mlarroque/electro2-TP1/cover.tex

%%%%%%%%%%%%%%%%%%%%%%%%%%%%%%%%%%%%%%%%% 
% University Assignment Title Page  
% LaTeX Template % Version 1.0 (27/12/12) 
% % This template has been downloaded from: 
% http://www.LaTeXTemplates.com % % Original author: 
% WikiBooks (http://en.wikibooks.org/wiki/LaTeX/Title_Creation) % % License: 
% CC BY-NC-SA 3.0 (http://creativecommons.org/licenses/by-nc-sa/3.0/) 
%  % Instructions for using this template: 
% This title page is capable of being compiled as is. This is not useful for  
% including it in another document. To do this, you have two options:  
% % 1) Copy/paste everything between \begin{document} and \end{document}  
% starting at \begin{titlepage} and paste this into another LaTeX file where you  
% want your title page. 
% OR % 2) Remove everything outside the \begin{titlepage} and \end{titlepage} and  
% move this file to the same directory as the LaTeX file you wish to add it to.  
% Then add \input{./title_page_1.tex} to your LaTeX file where you want your 
% title page. % %%%%%%%%%%%%%%%%%%%%%%%%%%%%%%%%%%%%%%%%% %\title{Title page with logo} 
%---------------------------------------------------------------------------------------- 
%	PACKAGES AND OTHER DOCUMENT CONFIGURATIONS 
%----------------------------------------------------------------------------------------      
\begin{titlepage}          
\newcommand{\HRule}
{\rule{\linewidth}{0.5mm}} 
% Defines a new command for the horizontal lines, change thickness here              
\center 
% Center everything on the page               
%----------------------------------------------------------------------------------------    
%	HEADING SECTIONS     
%----------------------------------------------------------------------------------------              
\textsc{\LARGE Instituto Tecnológico de Buenos Aires}\\[2cm] 
% Name of your university/college     
\textsc{\Large 22.12 - Electronica II}\\[1.5cm] 
% Major heading such as course name     
%
\textsc{\large Trabajo Práctico de Laboratorio N°1}\\[0.5cm] 
% Minor heading such as course title              
%----------------------------------------------------------------------------------------    
%	TITLE SECTION    
%----------------------------------------------------------------------------------------          
\HRule \\[0.5cm]     
{ \huge \bfseries Fuente Regulada de Tensión}\\[0.4cm] % Title of your document     
\HRule \\[2cm]               
%----------------------------------------------------------------------------------------     
%	AUTHOR SECTION     
%----------------------------------------------------------------------------------------             
\begin{minipage}{0.4\textwidth}     
\begin{flushleft} \large     
\emph{Grupo 2:}\\		
%names     
[.3cm]     Matías \textsc{Larroque}\\     Leg. 56597\\      [.3cm]         
Tomás Agustín \textsc{González Orlando}\\     Leg. 57090\\      [.3cm]        
Manuel \textsc{Mollón}\\     Leg. 58023\\      [.3cm]     
Ezequiel \textsc{Vijande}\\     Leg. 58057\\      [.3cm]     
\end{flushleft}     
\end{minipage}     ~     
\begin{minipage}{0.4\textwidth}     
\begin{flushright} \large     \emph{Profesor:} \\     [.3cm]     
Gustavo Abraham \textsc{Hirchoren}\\ % Supervisor's Name 
Javier David \textsc{Petrucci}\\     \end{flushright}     \end{minipage}\\[2cm]              
% If you don't want a supervisor, uncomment the two lines below and remove the section above     
%\Large \emph{Author:}\\     
%John \textsc{Smith}\\[3cm] 
% Your name             
%----------------------------------------------------------------------------------------     
%	DATE SECTION     
%----------------------------------------------------------------------------------------              
\vfill     
{\large Entregado: 25 de Abril de 2019}\\[2cm] 
% Date, change the \today to a set date if you want to be precise              %----------------------------------------------------------------------------------------     
%	LOGO SECTION    
%----------------------------------------------------------------------------------------             
%\includegraphics{logo.png}\\[1cm] 
% %Include a department/university logo - this will require the graphicx %package               %----------------------------------------------------------------------------------------              
%\vfill % Fill the rest of the page with whitespace              
\end{titlepage}
