mlarroque/electro2-TP1/Altium/Project Outputs for fuenteRegulada/Board Information - fuenteRegulada.txt

Board Information Report
Filename     : C:\Users\malen\Desktop\ELECTRONICA II\electro2-TP1\Altium\fuenteRegulada.PcbDoc
Date         : 15/4/2019
Time         : 10:05:56
Time Elapsed : 00:00:00

General
    Board Size, 50mmx50mm
    Components on board, 19
count : 2

Routing Information
    Routing completion, 100,00%
    Connections, 37
    Connections routed, 37
    Connections remaining, 0
count : 4
