mlarroque/electro2-TP1/imagenes/medRend6con5ohms.PNG

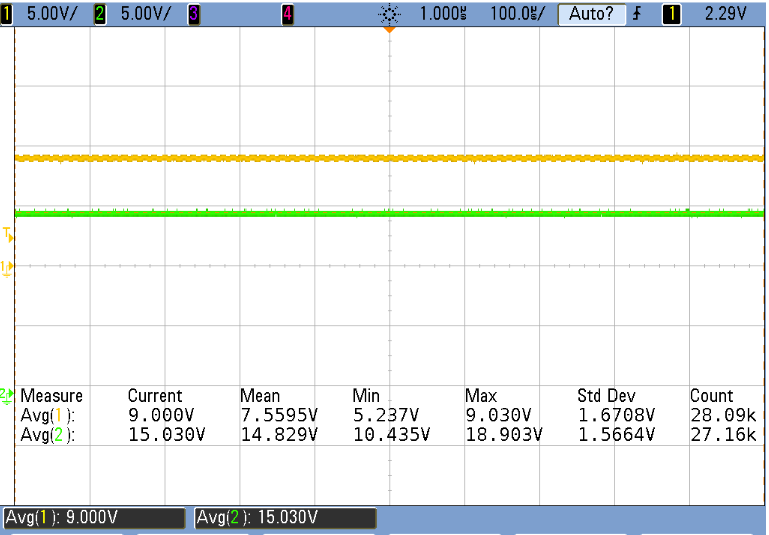
imagenes/medRend6con5ohms.PNG
