mlarroque/electro2-TP1/imagenes/medRend180ohms.PNG

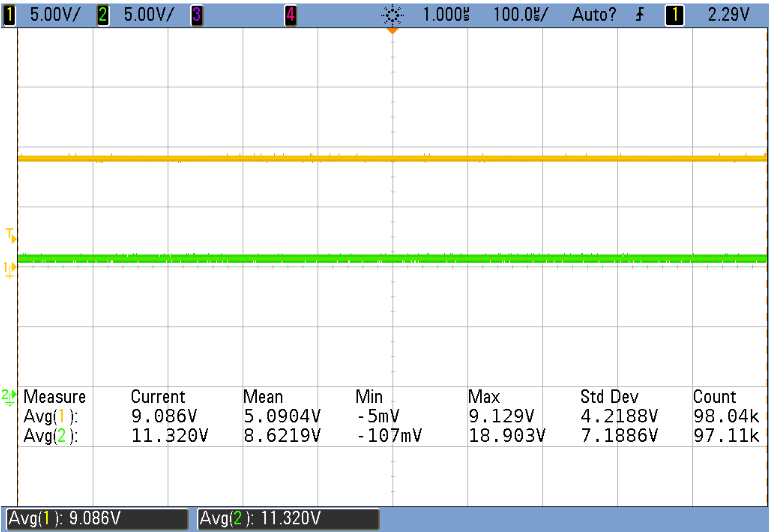
imagenes/medRend180ohms.PNG
