mlarroque/electro2-TP1/imagenes/medRend190ohms.PNG

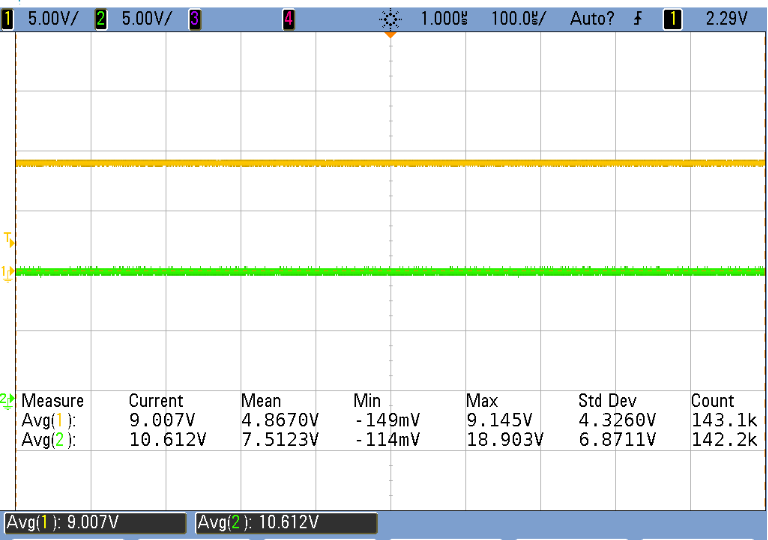
imagenes/medRend190ohms.PNG
