mlarroque/electro2-TP1/imagenes/medRendVacio.PNG

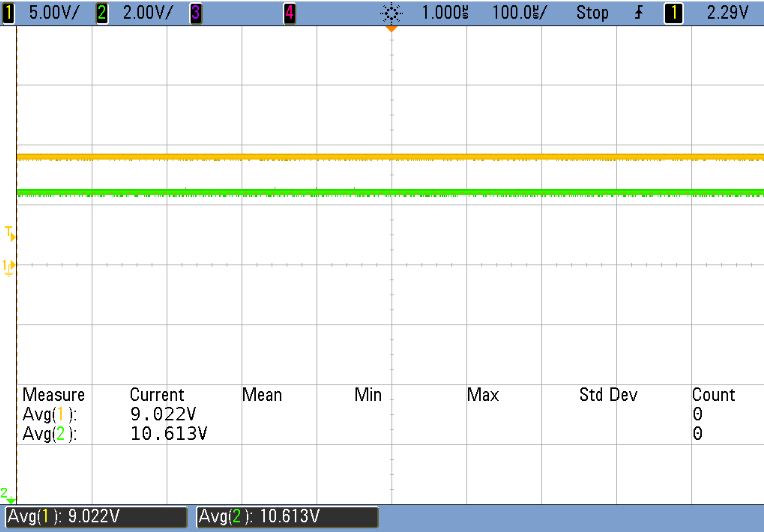
imagenes/medRendVacio.PNG
