mlarroque/electro2-TP1/mediciones/rend190ohms.png

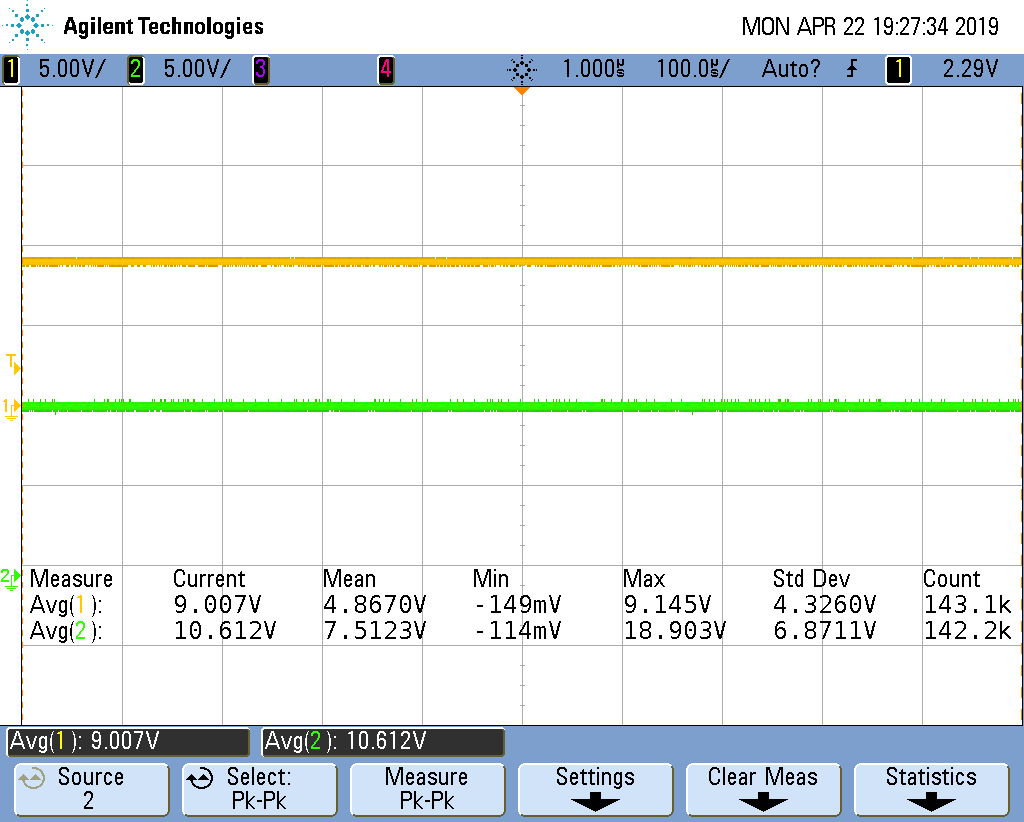
mediciones/rend190ohms.png
