mlarroque/electro2-TP1/mediciones/scope_21.png

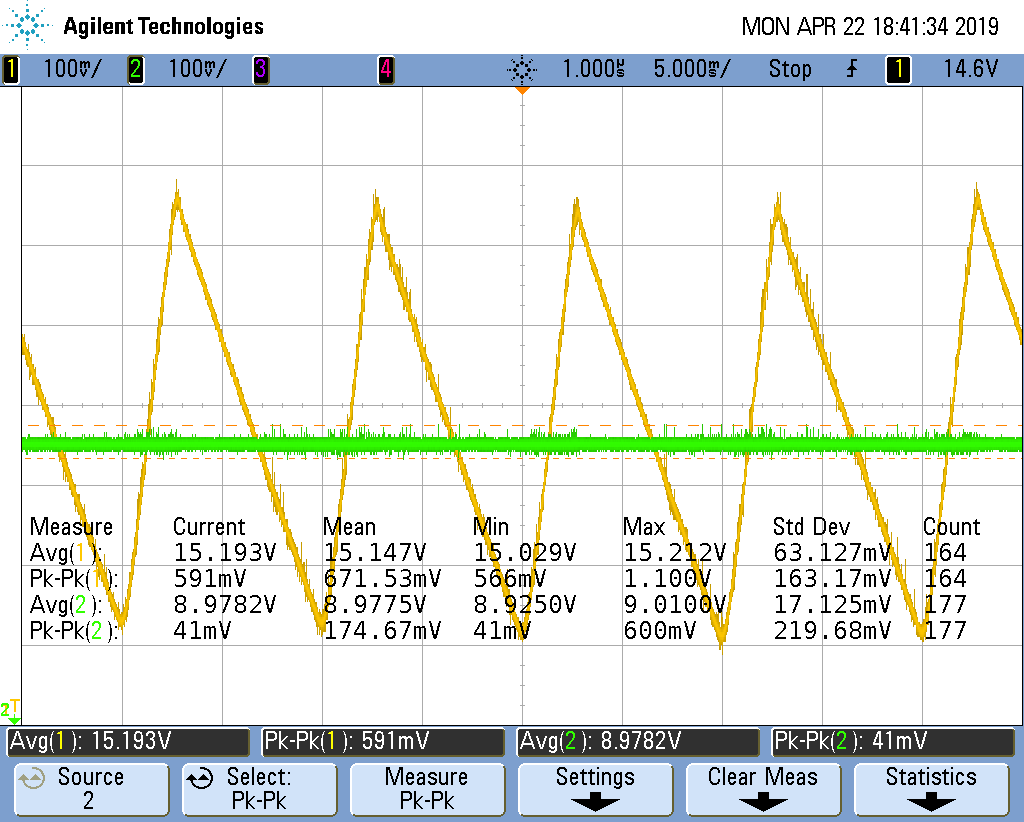
mediciones/scope_21.png
