mlarroque/electro2-TP1/mediciones/scope_22.png

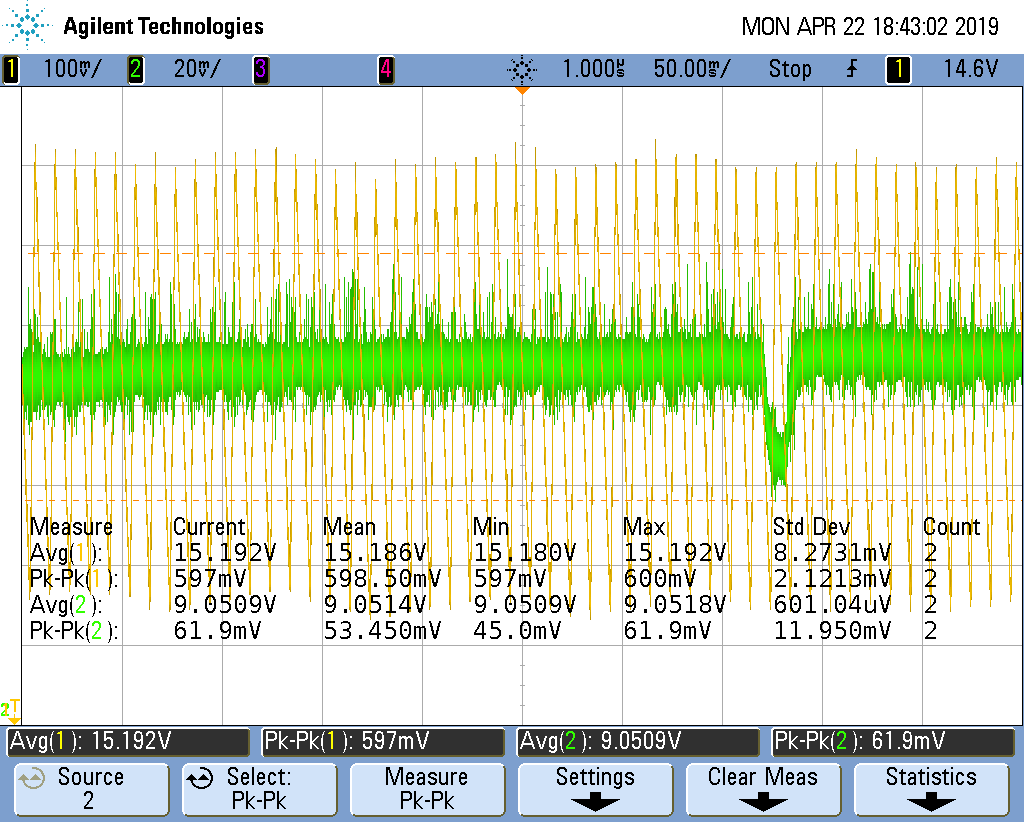
mediciones/scope_22.png
