mlarroque/electro2-TP1/mediciones/scope_23.png

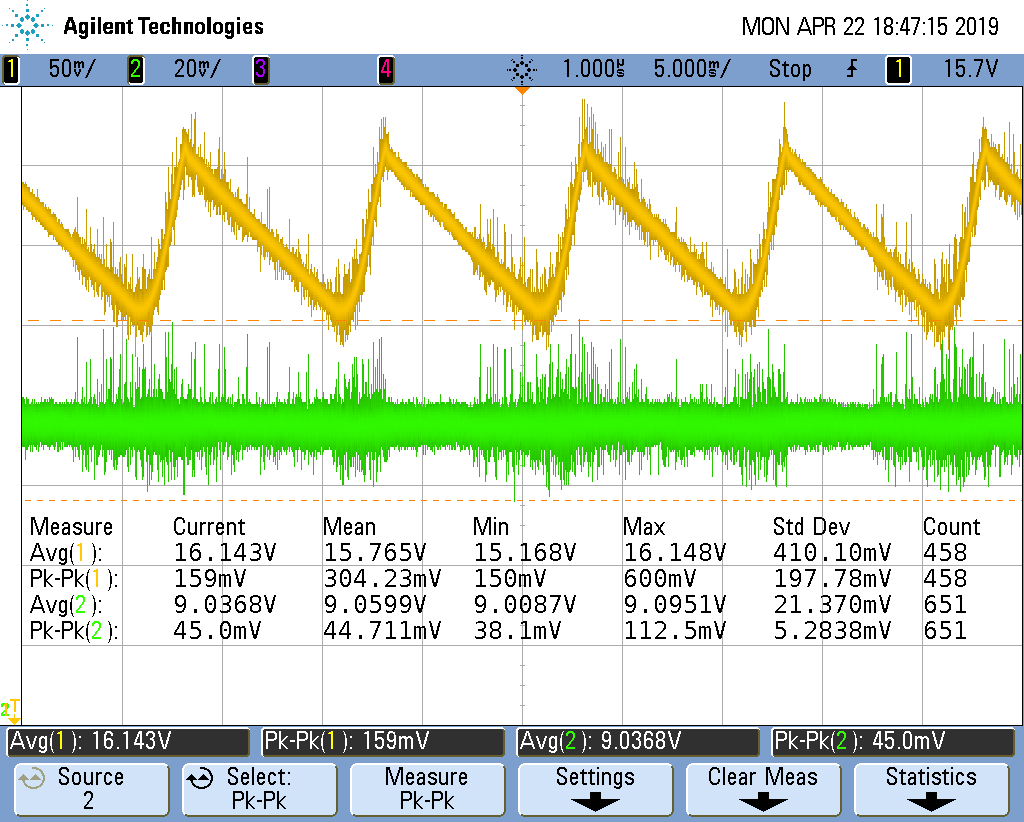
mediciones/scope_23.png
