mlarroque/electro2-TP1/mediciones/scope_24.png

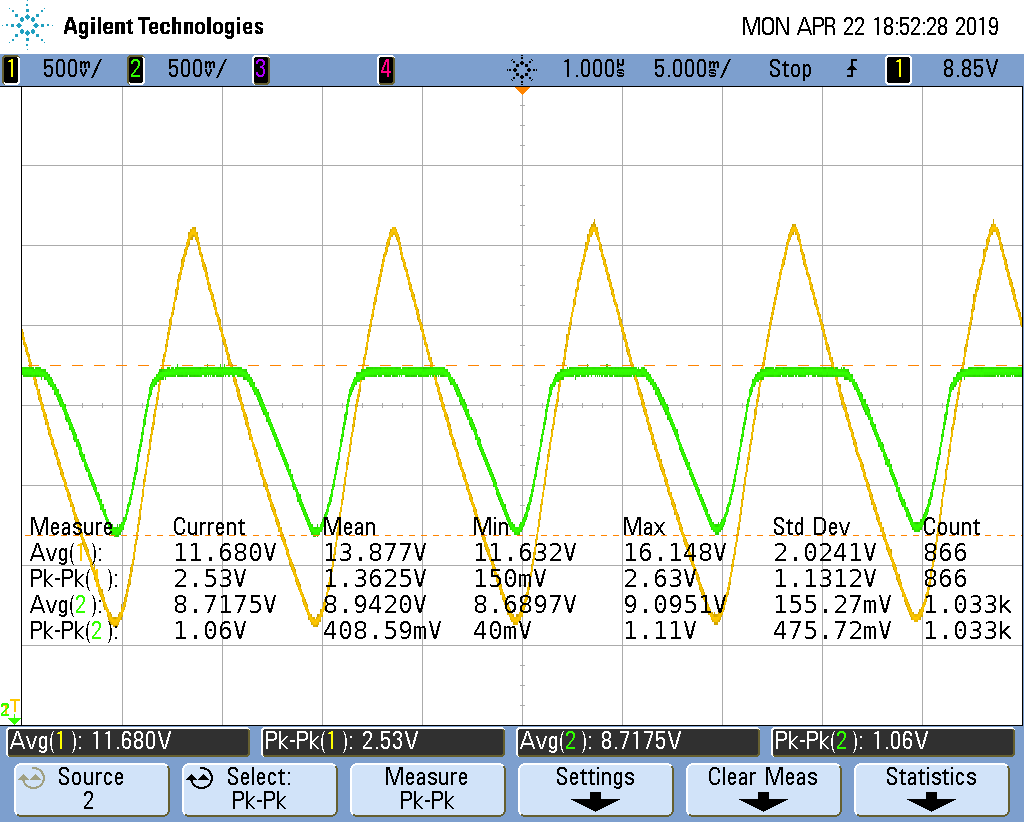
mediciones/scope_24.png
