mlarroque/electro2-TP1/mediciones/scope_25.png

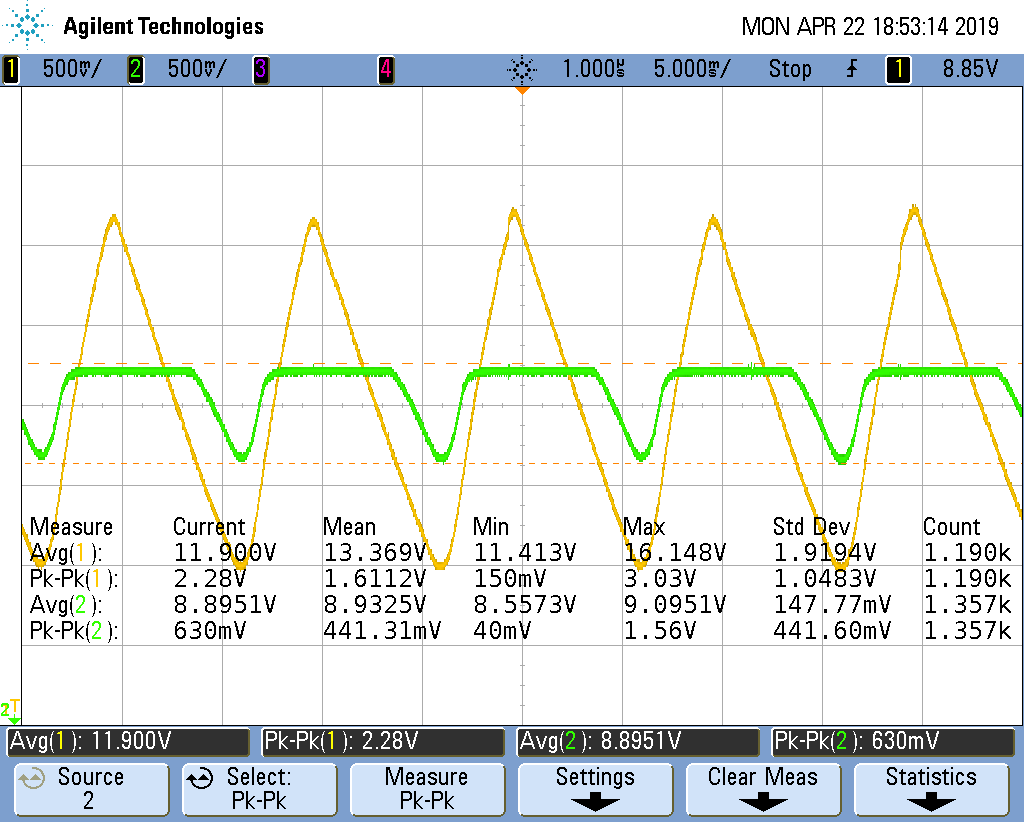
mediciones/scope_25.png
