mlarroque/electro2-TP1/mediciones/scope_26.png

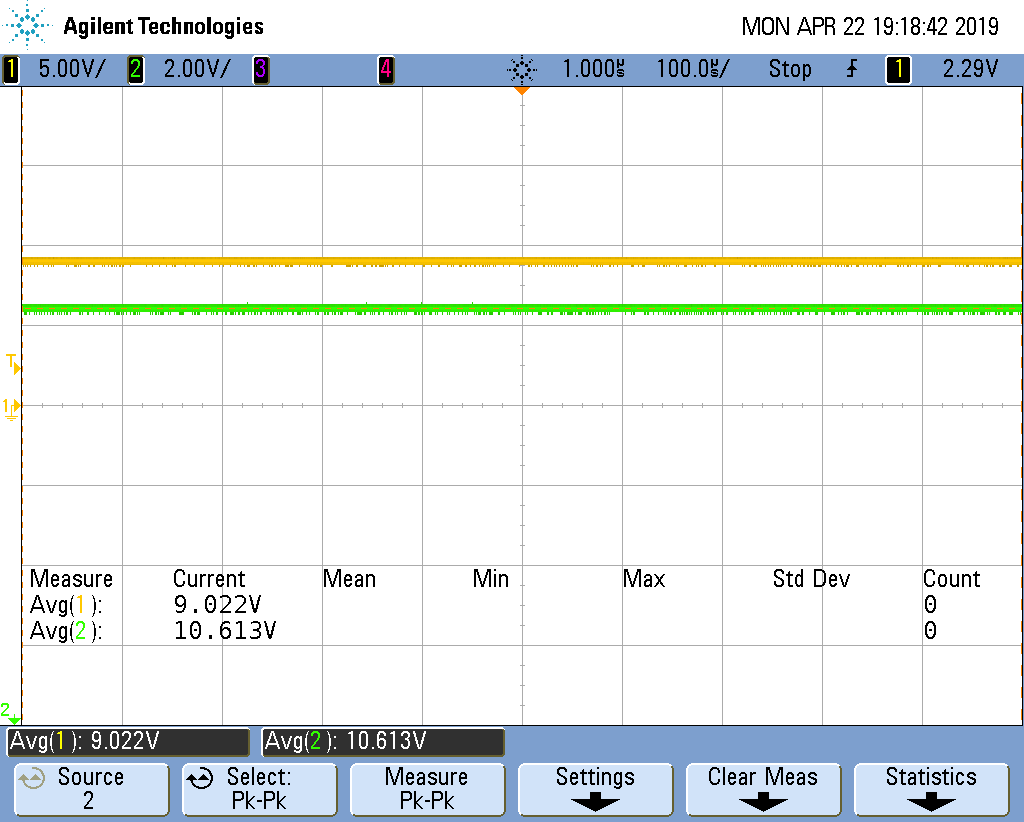
mediciones/scope_26.png
