mlarroque/electro2-TP1/mediciones/scope_28.png

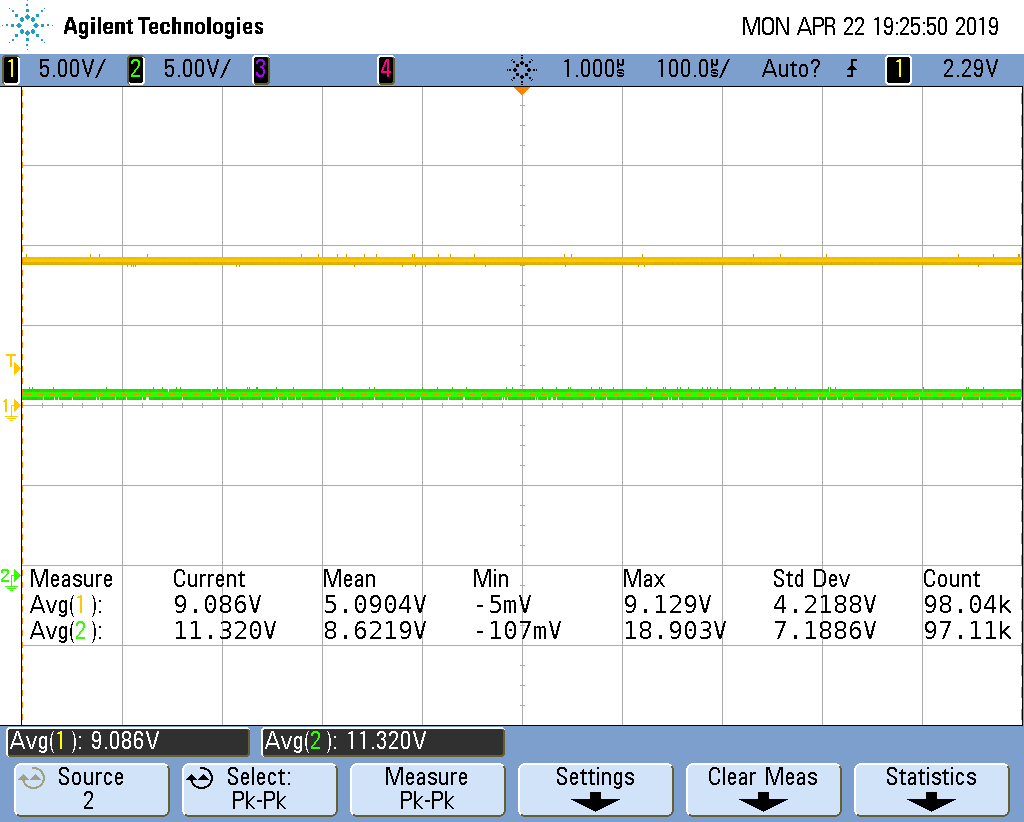
mediciones/scope_28.png
