mlarroque/electro2-TP1/fuenteRegulada.pdf

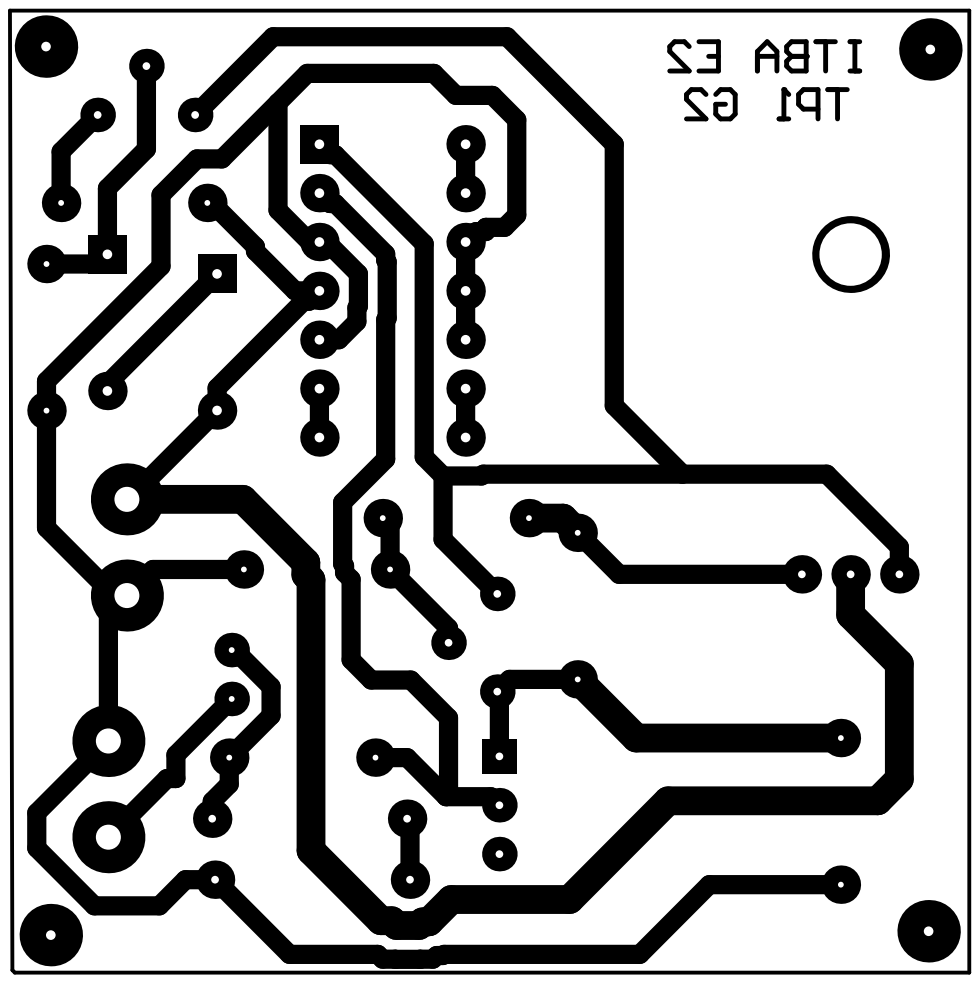
[picture p45: page 1]
