mlarroque/electro2-TP1/foldback.asc

Q1: npn
Q2: npn
Ra: res; 1
Rb: res; 610
Rc: res; 8453
Rload: res; {r}
V1: voltage; 30
V3: voltage; 12
Named nets: 0
.step param r 10k 1000k 10k
.tran 0 1us 0
