mlarroque/electro2-TP1/simulacionesLTspice/simGlazo.asc

C1: cap; 1000n
D1: diode; 1N4148
D2: diode; 1N4148
D3: zener; 1N750
Q1: npn; TIP122
Q2: npn; BC547B
Q3: pnp; BC557B
R1: res; 100
R2: res; 470
R3: res; 900
R4: res; 1
R5: res; 604
R6: res; 47k
R7: res; 820
R8: res; 8k4
R9: res; 10k
U1: opamp2; LM324
V1: voltage; 15
V2: voltage; 7.7
Named nets: 0, V-, Vd, Vcrit, Vopamp
.tran 1ms
.inc LM324.txt
.lib "C:\\Program Files\\LTC\\LTspiceXVII\\lib\\''TIP122''.lib"
