mlarroque/electro2-TP1/(list of files, drawings)

Other design files:
Altium/fuenteRegulada.PcbDoc
Altium/fuenteRegulada.PrjPCB
Altium/fuenteRegulada.SchDoc
Altium/History/fuenteRegulada.~(4).PcbDoc
Altium/History/fuenteRegulada.~(11).PcbDoc
