mlarroque/electro2-TP1/(commit log)

2019-04-14 esquematico listo
    [foldback.SchDoc, fuenteRegulada.PrjPCB, fuenteRegulada.SchDoc]
2019-04-15 simulacion de circuito sin proteccion todavia
2019-04-15 ruteo terminado
    [fuenteRegulada.PcbDoc, fuenteRegulada.PrjPCB, fuenteRegulada.SchDoc]
2019-04-15 cambios en el circuito
2019-04-16 se suben mediciones
    [medicionesCaracteristicaDeSalida.xlsx]
2019-04-16 junte las simulaciones de FOLDBACK Y CIRCUITO TOTAL
2019-04-17 se agregan simulaciones de Glazo
2019-04-17 se suben mas mediciones
    [medicionesCaracteristicaDeSalida.xlsx]
2019-04-22 se agregan mediciones, solo falta medir Rout
    [medicionesCaracteristicaDeSalida.xlsx]
2019-04-24 se avanza con el informe y mediciones
    [med2graph.xlsx]
2019-04-25 Un par de imagenes para el informe
2019-04-25 2 mas para manusa, sale con fritas
